hedj/radio/README.md

radio
=====

A minimal software-defined radio, based on the GreenArrays GA144A12 microprocessor.
Provision is made for connection to a Raspberry Pi B+ and shields. The GA144 analog
i/o pins are brought out to pin-headers to allow for different choices of RF frontends.
