hedj/radio/hardware/radio.kicad_pcb

## KiCad design hardware/radio.kicad_pcb (2015-06-11)

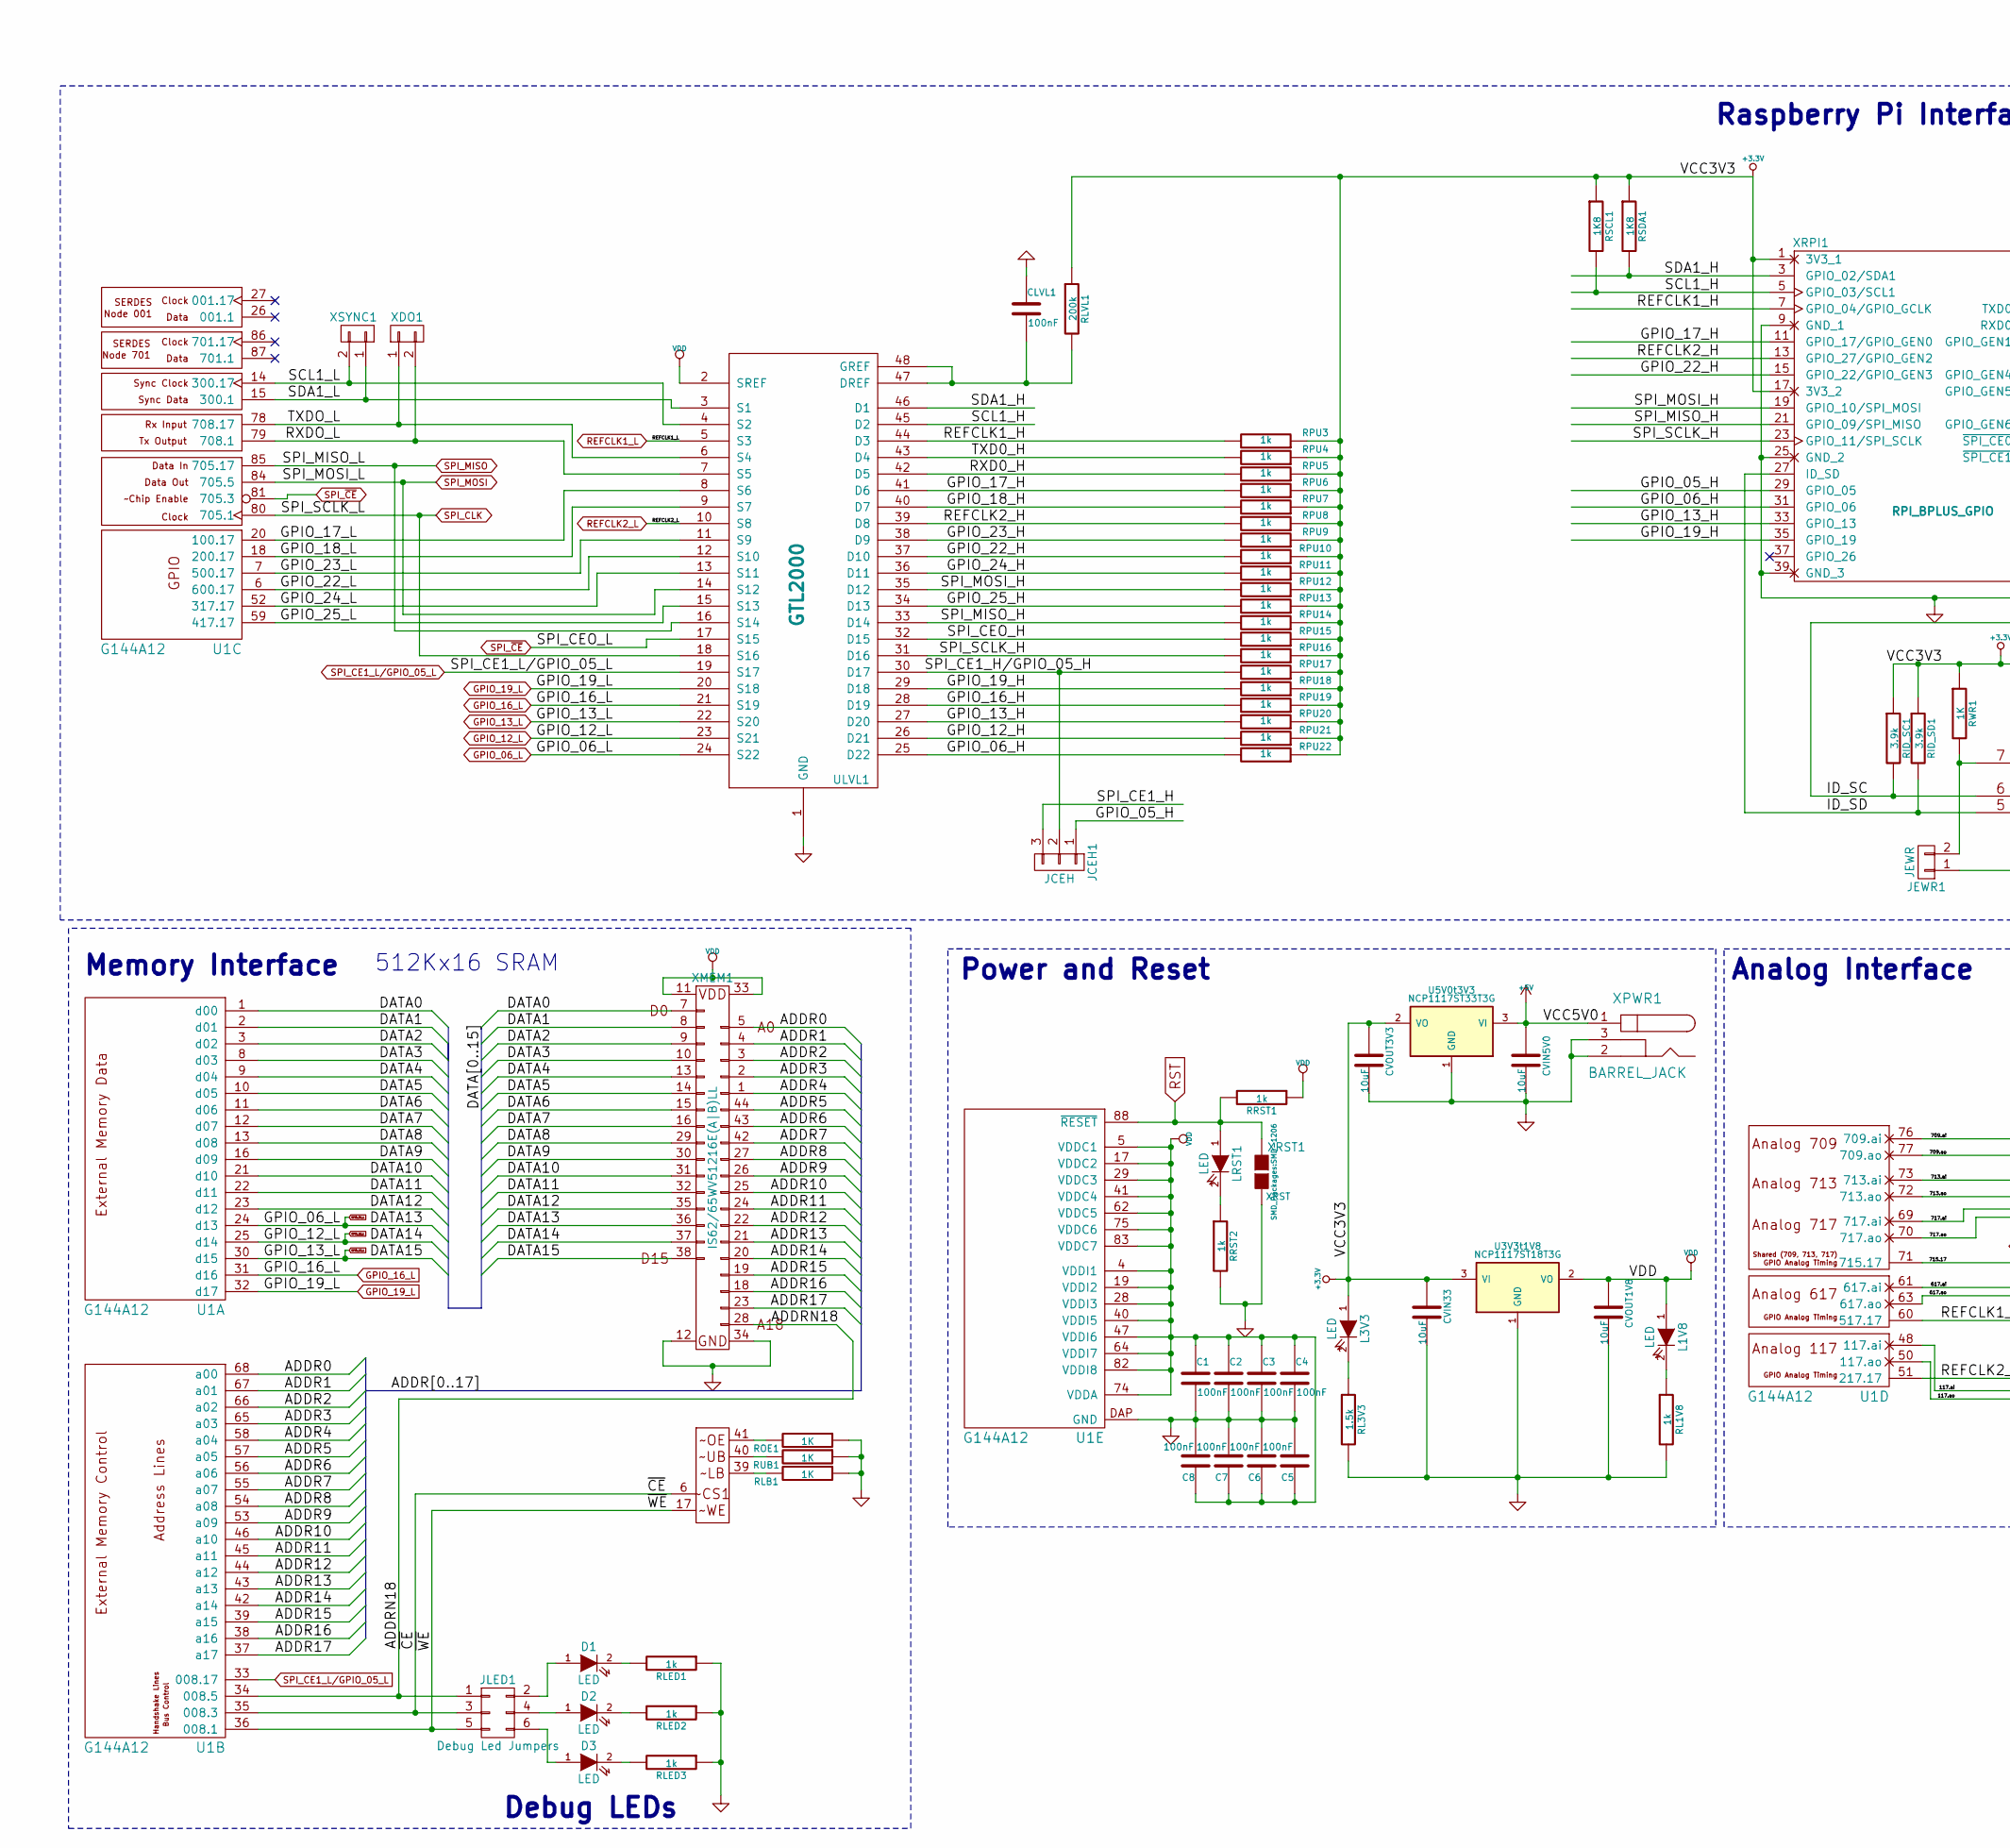
[picture p1: schematic radio.sch, part in row 1, column 1]

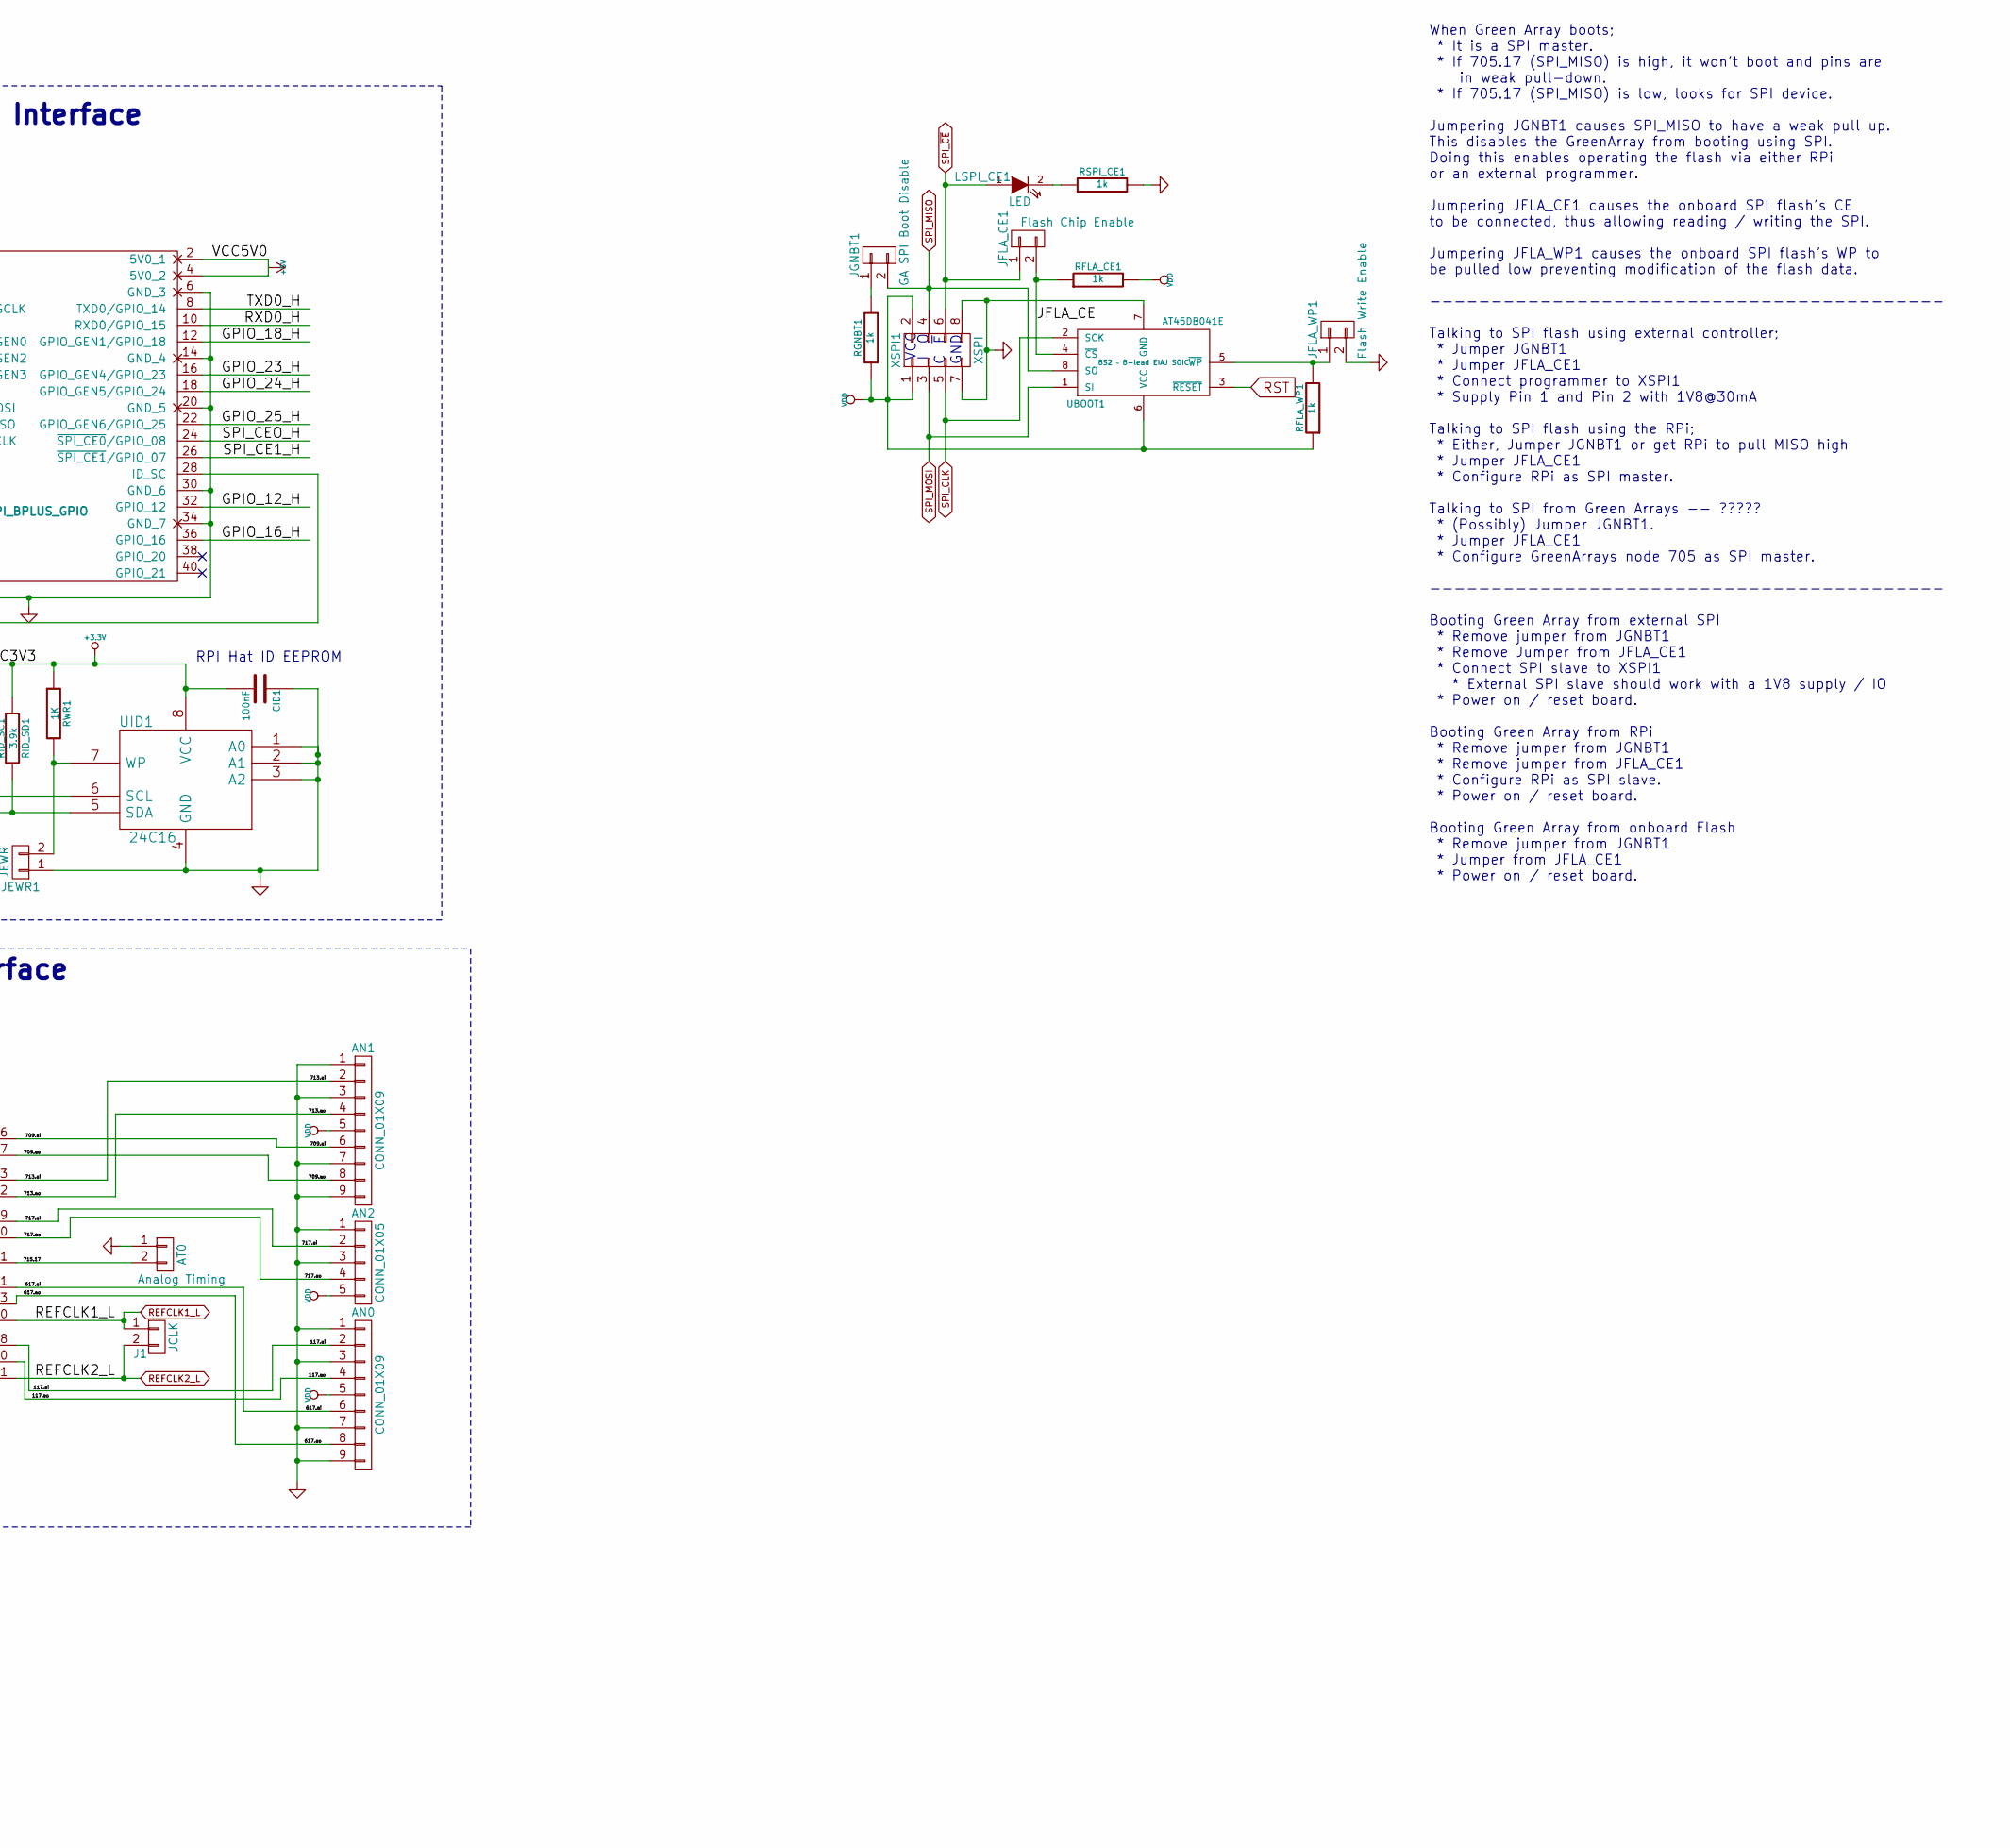
[picture p2: schematic radio.sch, part in row 1, column 2]

Parts:
AN0, AN1: CONN_01X09; Pin_Header_Straight_1x09
AN2: CONN_01X05; Pin_Header_Straight_1x05
AT0: Analog Timing; Pin_Header_Straight_1x02
C1, C2, C3, C4, C5, C6, C7, C8: 100nF; SMD-0603
CID1: 100nF; SMD-0603
CLVL1: 100nF; SMD-0603
CVIN5V0, CVIN33: 10uF; SMD-0805
CVOUT1V8, CVOUT3V3: 10uF; SMD-0805
D1, D2, D3: LED; LED-0805
J1: JCLK; Pin_Header_Straight_1x02
JCEH1: JCEH; Pin_Header_Straight_1x03
JEWR1: JEWR; Pin_Header_Straight_1x02
JFLA_CE1: Flash Chip Enable; Pin_Header_Straight_1x02
JFLA_WP1: Flash Write Enable; Pin_Header_Straight_1x02
JGNBT1: GA SPI Boot Disable; Pin_Header_Straight_1x02
JLED1: Debug Led Jumpers; Pin_Header_Straight_2x03
L1V8, L3V3: LED; LED-0805
LRST1: LED; LED-0805
LSPI_CE1: LED; LED-0805
RFLA_CE1: 1k; R_0603
RFLA_WP1: 1k; R_0603
RGNBT1: 1k; R_0603
RID_SC1: 3.9k; R_0603
RID_SD1: 3.9k; R_0603
RL1V8: 1k; R_0603
RL3V3: 1.5k; R_0603
RLB1: 1K; R_0603
RLED1, RLED2, RLED3: 1k; R_0603
RLVL1: 200k; R_0603
ROE1: 1K; R_0603
RPU3, RPU4, RPU5, RPU6, RPU7, RPU8, RPU9, RPU10, RPU11, RPU12, RPU13, RPU14, RPU15, RPU16, RPU17, RPU18, RPU19, RPU20, RPU21, RPU22: 1k; R_0603
RRST1, RRST2: 1k; R_0603
RSCL1: 1K8; R_0603
RSDA1: 1K8; R_0603
RSPI_CE1: 1k; R_0603
RUB1: 1K; R_0603
RWR1: 1K; R_0603
U1: G144A12; qfn88
U3V3t1V8: NCP1117ST18T3G; SOT-223
U5V0t3V3: NCP1117ST33T3G; SOT-223
UBOOT1: AT45DB041E; SOIC-8-N
UID1: 24C16; SOIC-8-N
ULVL1: GTL2000; TSSOP-48
XDO1: Pin_Header_Straight_1x02
XMEM1: IS62/65WV51216E(A|B)LL; TSSOPII-44_0.8mmPitch
XPWR1: BARREL_JACK
XRPI1: RPI_BPLUS_GPIO; PIN_20X2
XRST1: XRST; SMD-1206
XSPI1: XSPI; Pin_Header_Straight_2x04
XSYNC1: Pin_Header_Straight_1x02

Connections:
+3.3V: CID1.2, CVIN33.1, CVOUT3V3.1, L3V3.1 (A), RID_SC1.1, RID_SD1.1, RLVL1.1, RPU3.1, RPU4.1, RPU5.1, RPU6.1, RPU7.1, RPU8.1, RPU9.1, RPU10.1, RPU11.1, RPU12.1, RPU13.1, RPU14.1, RPU15.1, RPU16.1, RPU17.1, RPU18.1, RPU19.1, RPU20.1, RPU21.1, RPU22.1, RSCL1.1, RSDA1.1, RWR1.1, U3V3t1V8.3 (VI), U5V0t3V3.2 (VO), U5V0t3V3.4, UID1.8 (VCC), XRPI1.1 (3V3_1), XRPI1.17 (3V3_2)
+5V: CVIN5V0.1, U5V0t3V3.3 (VI), XPWR1.1, XRPI1.2 (5V0_1), XRPI1.4 (5V0_2)
/117.ai: AN0.2, U1.48 (117.ai)
/117.ao: AN0.4, U1.50 (117.ao)
/617.ai: AN0.6, U1.61 (617.ai)
/617.ao: AN0.8, U1.63 (617.ao)
/709.ai: AN1.6, U1.76 (709.ai)
/709.ao: AN1.8, U1.77 (709.ao)
/713.ai: AN1.2, U1.73 (713.ai)
/713.ao: AN1.4, U1.72 (713.ao)
/715.17: AT0.2, U1.71 (715.17)
/717.ai: AN2.2, U1.69 (717.ai)
/717.ao: AN2.4, U1.70 (717.ao)
/ADDR0: U1.68 (a00), XMEM1.5
/ADDR1: U1.67 (a01), XMEM1.4
/ADDR2: U1.66 (a02), XMEM1.3
/ADDR3: U1.65 (a03), XMEM1.2
/ADDR4: U1.58 (a04), XMEM1.1
/ADDR5: U1.57 (a05), XMEM1.44
/ADDR6: U1.56 (a06), XMEM1.43
/ADDR7: U1.55 (a07), XMEM1.42
/ADDR8: U1.54 (a08), XMEM1.27
/ADDR9: U1.53 (a09), XMEM1.26
/ADDR10: U1.46 (a10), XMEM1.25
/ADDR11: U1.45 (a11), XMEM1.24
/ADDR12: U1.44 (a12), XMEM1.22
/ADDR13: U1.43 (a13), XMEM1.21
/ADDR14: U1.42 (a14), XMEM1.20
/ADDR15: U1.39 (a15), XMEM1.19
/ADDR16: U1.38 (a16), XMEM1.18
/ADDR17: U1.37 (a17), XMEM1.23
/ADDRN18: JLED1.1, U1.34 (008.5), XMEM1.28
/DATA0: U1.1 (d00), XMEM1.7
/DATA1: U1.2 (d01), XMEM1.8
/DATA2: U1.3 (d02), XMEM1.9
/DATA3: U1.8 (d03), XMEM1.10
/DATA4: U1.9 (d04), XMEM1.13
/DATA5: U1.10 (d05), XMEM1.14
/DATA6: U1.11 (d06), XMEM1.15
/DATA7: U1.12 (d07), XMEM1.16
/DATA8: U1.13 (d08), XMEM1.29
/DATA9: U1.16 (d09), XMEM1.30
/DATA10: U1.21 (d10), XMEM1.31
/DATA11: U1.22 (d11), XMEM1.32
/DATA12: U1.23 (d12), XMEM1.35
/GPIO_05_H: JCEH1.1, XRPI1.29 (GPIO_05)
/GPIO_06_H: RPU22.2, ULVL1.25 (D22), XRPI1.31 (GPIO_06)
/GPIO_12_H: RPU21.2, ULVL1.26 (D21), XRPI1.32 (GPIO_12)
/GPIO_13_H: RPU20.2, ULVL1.27 (D20), XRPI1.33 (GPIO_13)
/GPIO_16_H: RPU19.2, ULVL1.28 (D19), XRPI1.36 (GPIO_16)
/GPIO_17_H: RPU6.2, ULVL1.41 (D6), XRPI1.11 (GPIO_17/GPIO_GEN0)
/GPIO_17_L: U1.20 (100.17), ULVL1.8 (S6)
/GPIO_18_H: RPU7.2, ULVL1.40 (D7), XRPI1.12 (GPIO_GEN1/GPIO_18)
/GPIO_18_L: U1.18 (200.17), ULVL1.9 (S7)
/GPIO_19_H: RPU18.2, ULVL1.29 (D18), XRPI1.35 (GPIO_19)
/GPIO_22_H: RPU10.2, ULVL1.37 (D10), XRPI1.15 (GPIO_22/GPIO_GEN3)
/GPIO_22_L: U1.6 (600.17), ULVL1.12 (S10)
/GPIO_23_H: RPU9.2, ULVL1.38 (D9), XRPI1.16 (GPIO_GEN4/GPIO_23)
/GPIO_23_L: U1.7 (500.17), ULVL1.11 (S9)
/GPIO_24_H: RPU11.2, ULVL1.36 (D11), XRPI1.18 (GPIO_GEN5/GPIO_24)
/GPIO_24_L: U1.52 (317.17), ULVL1.13 (S11)
/GPIO_25_H: RPU13.2, ULVL1.34 (D13), XRPI1.22 (GPIO_GEN6/GPIO_25)
/GPIO_25_L: U1.59 (417.17), ULVL1.15 (S13)
/ID_SC: RID_SC1.2, UID1.6 (SCL), XRPI1.28 (ID_SC)
/ID_SD: RID_SD1.2, UID1.5 (SDA), XRPI1.27 (ID_SD)
/JFLA_CE: JFLA_CE1.2, RFLA_CE1.1, UBOOT1.4 (~CS)
/REFCLK1_H: RPU3.2, ULVL1.44 (D3), XRPI1.7 (GPIO_04/GPIO_GCLK)
/REFCLK2_H: RPU8.2, ULVL1.39 (D8), XRPI1.13 (GPIO_27/GPIO_GEN2)
/RXD0_H: RPU5.2, ULVL1.42 (D5), XRPI1.10 (RXD0/GPIO_15)
/RXDO_L: U1.79 (708.1), ULVL1.7 (S5), XDO1.2
/SCL1_H: RSCL1.2, ULVL1.45 (D2), XRPI1.5 (GPIO_03/SCL1)
/SCL1_L: U1.14 (300.17), ULVL1.4 (S2), XSYNC1.2
/SDA1_H: RSDA1.2, ULVL1.46 (D1), XRPI1.3 (GPIO_02/SDA1)
/SDA1_L: U1.15 (300.1), ULVL1.3 (S1), XSYNC1.1
/SPI_CE1_H: JCEH1.3, XRPI1.26 (~SPI_CE1~/GPIO_07)
/SPI_CE1_H/GPIO_05_H: JCEH1.2, RPU17.2, ULVL1.30 (D17)
/SPI_CEO_H: RPU15.2, ULVL1.32 (D15), XRPI1.24 (~SPI_CE0~/GPIO_08)
/SPI_MISO_H: RPU14.2, ULVL1.33 (D14), XRPI1.21 (GPIO_09/SPI_MISO)
/SPI_MOSI_H: RPU12.2, ULVL1.35 (D12), XRPI1.19 (GPIO_10/SPI_MOSI)
/SPI_SCLK_H: RPU16.2, ULVL1.31 (D16), XRPI1.23 (GPIO_11/SPI_SCLK)
/TXD0_H: RPU4.2, ULVL1.43 (D4), XRPI1.8 (TXD0/GPIO_14)
/TXDO_L: U1.78 (708.17), ULVL1.6 (S4), XDO1.1
/~CE: JLED1.3, U1.35 (008.3), XMEM1.6
/~WE: JLED1.5, U1.36 (008.1), XMEM1.17
GND: AN0.1, AN0.3, AN0.7, AN0.9, AN1.1, AN1.3, AN1.7, AN1.9, AN2.1, AN2.3, AT0.1, C1.2, C2.2, C3.2, C4.2, C5.2, C6.2, C7.2, C8.2, CID1.1, CLVL1.1, CVIN5V0.2, CVIN33.2, CVOUT1V8.2, CVOUT3V3.2, JEWR1.1, JFLA_WP1.2, RL1V8.2, RL3V3.2, RLB1.1, RLED1.1, RLED2.1, RLED3.1, ROE1.1, RRST2.2, RSPI_CE1.2, RUB1.1, U1.DAP (GND), U3V3t1V8.1 (GND), U5V0t3V3.1 (GND), UBOOT1.7 (GND), UID1.1 (A0), UID1.2 (A1), UID1.3 (A2), UID1.4 (GND), ULVL1.1 (GND), XMEM1.12, XMEM1.34, XPWR1.2, XPWR1.3, XRPI1.6 (GND_3), XRPI1.9 (GND_1), XRPI1.14 (GND_4), XRPI1.20 (GND_5), XRPI1.25 (GND_2), XRPI1.30 (GND_6), XRPI1.34 (GND_7), XRPI1.39 (GND_3), XRST1.2 (G2), XSPI1.7, XSPI1.8
GPIO_06_L: U1.24 (d13), ULVL1.24 (S22), XMEM1.36
GPIO_12_L: U1.25 (d14), ULVL1.23 (S21), XMEM1.37
GPIO_13_L: U1.30 (d15), ULVL1.22 (S20), XMEM1.38
GPIO_16_L: U1.31 (d16), ULVL1.21 (S19)
GPIO_19_L: U1.32 (d17), ULVL1.20 (S18)
unnamed: CLVL1.2, RLVL1.2, ULVL1.47 (DREF), ULVL1.48 (GREF)
unnamed: D1.1 (A), JLED1.2
unnamed: D1.2 (K), RLED1.2
unnamed: D2.1 (A), JLED1.4
unnamed: D2.2 (K), RLED2.2
unnamed: D3.1 (A), JLED1.6
unnamed: D3.2 (K), RLED3.2
unnamed: JEWR1.2, RWR1.2, UID1.7 (WP)
unnamed: JFLA_WP1.1, RFLA_WP1.2, UBOOT1.5 (~WP)
unnamed: JGNBT1.1, RGNBT1.2
unnamed: L1V8.2 (K), RL1V8.1
unnamed: L3V3.2 (K), RL3V3.1
unnamed: LRST1.2 (K), RRST2.1
unnamed: LSPI_CE1.2 (K), RSPI_CE1.1
unnamed: RLB1.2, XMEM1.39
unnamed: ROE1.2, XMEM1.41
unnamed: RUB1.2, XMEM1.40
REFCLK1_L: J1.1, U1.60 (517.17), ULVL1.5 (S3)
REFCLK2_L: J1.2, U1.51 (217.17), ULVL1.10 (S8)
RST: LRST1.1 (A), RRST1.2, U1.88 (~RESET), UBOOT1.3 (~RESET), XRST1.1 (G1)
SPI_CE1_L/GPIO_05_L: U1.33 (008.17), ULVL1.19 (S17)
SPI_CLK: U1.80 (705.1), UBOOT1.2 (SCK), ULVL1.18 (S16), XSPI1.5
SPI_MISO: JGNBT1.2, U1.85 (705.17), UBOOT1.8 (SO), ULVL1.16 (S14), XSPI1.4
SPI_MOSI: U1.84 (705.5), UBOOT1.1 (SI), ULVL1.14 (S12), XSPI1.3
SPI_~CE: JFLA_CE1.1, LSPI_CE1.1 (A), U1.81 (705.3), ULVL1.17 (S15), XSPI1.6
VDD: AN0.5, AN1.5, AN2.5, C1.1, C2.1, C3.1, C4.1, C5.1, C6.1, C7.1, C8.1, CVOUT1V8.1, L1V8.1 (A), RFLA_CE1.2, RFLA_WP1.1, RGNBT1.1, RRST1.1, U1.4 (VDDI1), U1.5 (VDDC1), U1.17 (VDDC2), U1.19 (VDDI2), U1.28 (VDDI3), U1.29 (VDDC3), U1.40 (VDDI5), U1.41 (VDDC4), U1.47 (VDDI6), U1.62 (VDDC5), U1.64 (VDDI7), U1.74 (VDDA), U1.75 (VDDC6), U1.82 (VDDI8), U1.83 (VDDC7), U3V3t1V8.2 (VO), U3V3t1V8.4, UBOOT1.6 (VCC), ULVL1.2 (SREF), XMEM1.11, XMEM1.33, XSPI1.1, XSPI1.2

Notes on the sheet:
Analog Interface
Power and Reset
Raspberry Pi Interface
Memory Interface
Debug LEDs
RPI Hat ID EEPROM
GND
VCC
512Kx16 SRAM
When Green Array boots; * It is a SPI master. * If 705.17 (SPI_MISO) is high, it won't boot and pins are in weak pull-down. * If 705.17 (SPI_MISO) is low, looks for SPI device. Jumpering JGNBT1 causes SPI_MISO to have a weak pull up. This disables the GreenArray from booting using SPI. Doing this e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

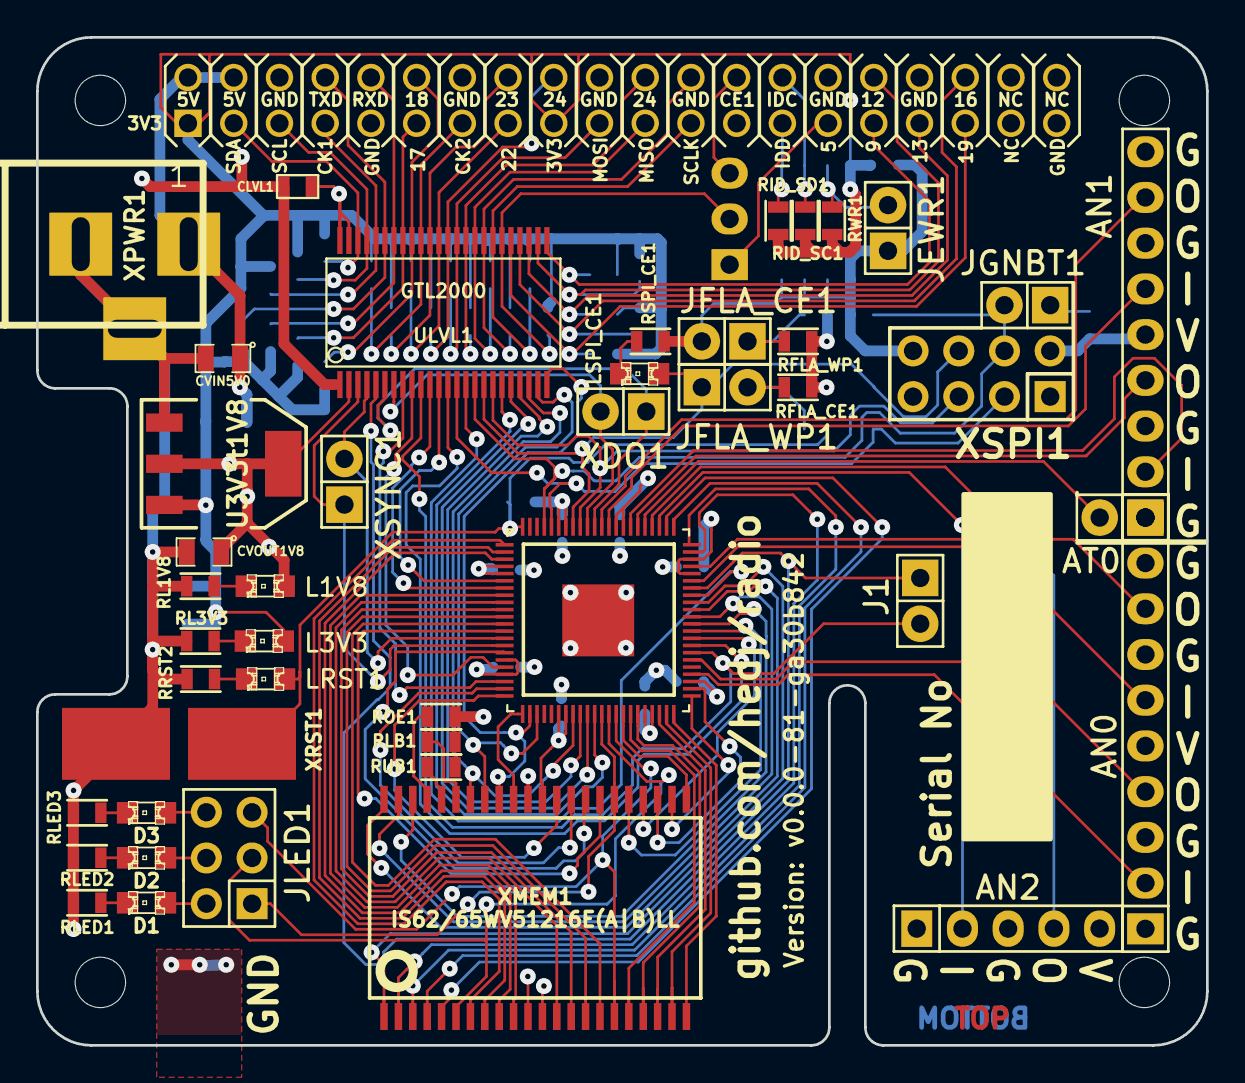
[picture p3: board radio.kicad_pcb from above]

Board: 4 copper layers, 65.0 x 56.0 mm, 89 parts (0 on the bottom side), 116 nets.

Other parts of the board:
@HOLE0, @HOLE1, @HOLE2, @HOLE3: (no value)
