hedj/radio/hardware/antenna.kicad_pcb

## KiCad design hardware/antenna.kicad_pcb (2015-06-06)

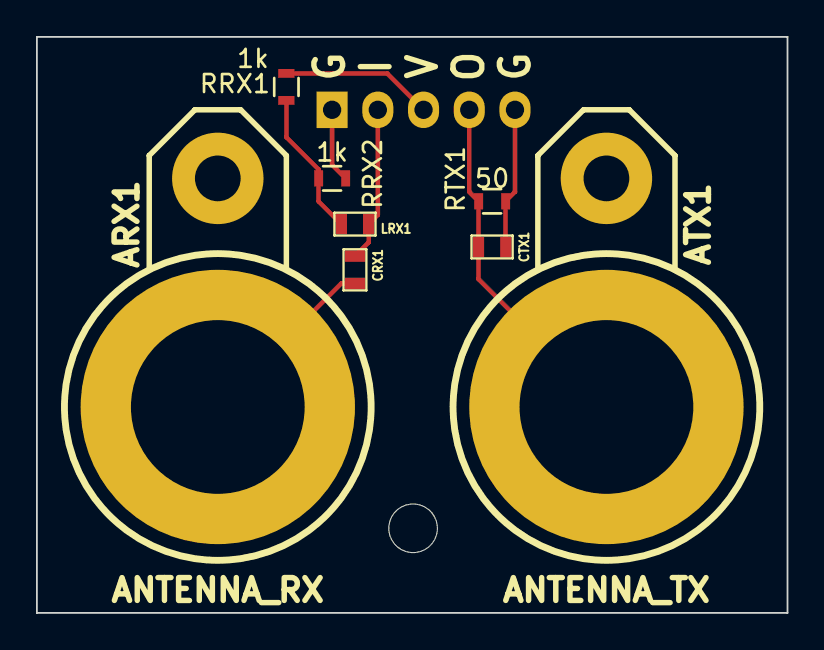
[picture p4: board antenna.kicad_pcb from above]

Board: 2 copper layers, 41.7 x 32.0 mm, 10 parts (1 on the bottom side), 6 nets.

Parts:
ARX1: ANTENNA_RX; bnc
ATX1: ANTENNA_TX; bnc
CRX1: 0.1uF; SMD-0603
CTX1: 320pF; SMD-0603
LRX1: 160nH; SMD-0603
MountingHole_2-7mm: VAL**; MountingHole_2-7mm
P1: CONN_01X05; Pin_Header_Straight_1x05
RRX1, RRX2: 1k; R_0603
RTX1: 50; R_0603

Connections:
AGND: ARX1.1, ATX1.1, CTX1.2, P1.1, P1.5, RRX2.2, RTX1.2
unnamed: ARX1.2, CRX1.1
unnamed: ATX1.2, CTX1.1, P1.4, RTX1.1
unnamed: CRX1.2, LRX1.2, P1.2
unnamed: LRX1.1, RRX1.2, RRX2.1
VDD: P1.3, RRX1.1
