hedj/radio/(threads)

Thread 3 (2015-04-14):

Extend solder pads for RAM chip

mithro, 2015-04-14:
The solder pads are too short for hand soldering. They need to be extended abit.

Closed 2015-06-03.

Thread 4 (2015-04-14):

Redo the power connector

mithro, 2015-04-14:

mithro, 2015-04-14:
The currently purchased version doesn't match the footprint.

mithro, 2015-06-03:
Purchase 5 of http://www.digikey.com/scripts/DkSearch/dksus.dll?Detail&itemSeq=173436971&uq=635689110560850630

Closed 2015-06-03.

Thread 5 (2015-04-14):

Extend the Green Array solder pads

mithro, 2015-04-14:
The Green Array pads are too short to be hand solderable.

Closed 2015-06-03.

Thread 6 (2015-04-14):

Get a new reset switch

mithro, 2015-04-14:
The current one purchased doesn't match the footprint.

mithro, 2015-06-05:
I just went with a large pad which will support multiple different types of switches.

Closed 2015-06-05.

Thread 13 (2015-06-27):

JFLA_CE1 and JFLA_WP1 silk screen labels should be swapped

mithro, 2015-06-27:
They are on the wrong side of the connectors which makes it confusing.

Thread 14 (2015-06-27):

Replace pull up resistors with resistor arrays.

mithro, 2015-06-27:
This would reduce the amount of soldering needed.

Thread 15 (2015-06-27):

Raspberry PI has no way of doing a hard reset of the GreenArrays chip.

mithro, 2015-06-27:
The RESET net is not connected to the Raspberry Pi and it has no control over the 3.3V supply to the board either. This means if the GreenArrays locks up in any way, you must press the reset button to reset the system.

Thread 17 (2015-06-27):

There isn't enough clearance between standoffs and the analog board connectors

mithro, 2015-06-27:
You can't really put any nuts on the standoffs or anything.

Thread 18 (2015-06-27):

Figure out why when board initially powers on it pulls 90mA, but after reset it goes to 10mA

mithro, 2015-06-27:
When power is initially connected to VCC3V3 the board starts drawing 90mA, but after asserting the reset line the board goes to only drawing 10mA.

mithro, 2015-06-29:
@hedj - Any idea what might be going on here?

Thread 19 (2015-06-27):

Need program for SPI flash which flashes the LEDs in a nice pattern.

mithro, 2015-06-27:
The LEDs are connected to;
 * D1 -> 008.5 (pin 34)
 * D2 -> 008.3 (pin 35)
 * D3 -> 008.1 (pin 36)

mithro, 2015-06-27:
@hedj - This task is for you :)

Thread 23 (2016-08-03):

Accidently deleted antenna board?

mithro, 2016-08-03:
It looks like you have accidently deleted the schematic in https://github.com/hedj/radio/commit/c5952ea59f1b8f2a943819fa592a28a82442f86b

Probably want to keep it?
