hedj/radio/(commit log)

2014-09-09 Cleanup redundant and obsolete files
    [footprint.sch]
2014-09-09 Add garfc, remove redundant files.
    [radio-4.sch]
2014-09-09 Add PDFs of schematics
2014-09-13 Fully created schematic and footprint associations.
    [radio.kicad_pcb, radio.sch]
2014-09-13 Partially routed schematic.
    [radio.kicad_pcb, radio.sch]
2014-09-13 Totally rework how the pull up resistors work.
    [radio.kicad_pcb, radio.sch]
2014-09-13 More routing of stuff.
    [radio.kicad_pcb]
2014-09-13 Minor fixes.
    [radio.kicad_pcb, radio.sch]
2014-09-14 Swapping SDA and SCLK to make routing easier.
    [radio.kicad_pcb]
2014-09-15 Adding SPI flash and changing the SPI setup.
    [radio.kicad_pcb, radio.sch]
2014-10-18 Adding mini-PCI Express expansion board as dependency.
2014-11-01 Adding the SATA connector library.
2014-11-01 Temporary commit with latest updated.
    [radio.kicad_pcb, radio.sch]
2014-11-01 Moving the antenna onto its own board.
    [antenna.sch]
2014-11-01 Removing the antenna from the radio schematic.
    [radio.sch]
2014-11-01 Preparing to hook up mPCIe connector and adding documentation.
    [radio.sch]
2014-11-01 Lots of different fixes.
    * Removing mpcie and replacing with onboard memory (freeing up some pins).
    * Changing the SPI configuration (don't actually need the fancy 3 way header).
    Added lots of documentation how to work with SPI flash for booting,
    programming, etc.
    * Fixed all the electrical DRC errors.
    [radio.sch]
2014-11-01 Adding a LED onto the SPI CE to make debugging easier.
    [radio.sch]
2014-11-01 Removing mpcie from PCB library.
2014-11-01 Temporary commit.
    [radio.sch]
2014-11-01 Use custom SATA connector for design-rule compatibility
    [antenna.sch]
2014-11-01 Adding SATA PCB module.
    [radio.sch]
2014-11-01 Back to pin headers rather than SATA connectors.
    [radio.sch]
2014-11-01 Bit of a cleanup, temporary commit.
    [radio.kicad_pcb]
2014-11-01 Fixing XSPI connector.
    [radio.sch]
2014-11-01 Temporary commit for netlist import.
    [radio.kicad_pcb, radio.sch]
2014-11-01 Imported new netlist and lined up analog headers.
    [radio.kicad_pcb]
2014-11-01 Starting initial layout of parts.
    [radio.kicad_pcb]
2014-11-02 Initial PCB layout for antenna
    [antenna.kicad_pcb, antenna.sch]
2014-11-15 Fixing the ground plane fill.
    [antenna.kicad_pcb]
2014-11-15 Adding dimensions of the antenna board.
    [antenna.kicad_pcb]
2014-11-15 Adding dimensions to radio board.
    [radio.kicad_pcb]
2014-11-15 Placing the barrel jack and power supply.
    [radio.kicad_pcb]
2014-11-15 Temp commit.
    [radio.kicad_pcb]
2014-11-15 Using older 603 footprint.
    [radio.kicad_pcb]
2014-11-15 Getting LEDs and reset points right.
    [radio.kicad_pcb]
2014-11-15 More work.
    [radio.sch]
2014-11-15 Slowly getting there....
    [radio.kicad_pcb]
2014-11-15 Reorganising the Analog header for easier routing.
    [radio.kicad_pcb, radio.sch]
2014-11-15 Analog bits connected now.
    [radio.kicad_pcb]
2014-11-15 Removing the XSERDES1 header.
    [radio.sch]
2014-11-15 KiCad crashed :(
    [radio.kicad_pcb]
2014-11-15 Finished most of the SPI stuff.
    [radio.kicad_pcb]
2014-11-15 Adding decoupling capacitors.
    [radio.kicad_pcb]
2014-11-15 Decoupling capacitors connected up.
    [radio.kicad_pcb]
2014-11-16 Adding the UART header.
    [radio.kicad_pcb]
2014-11-16 All traces routed I think.
    [radio.kicad_pcb]
2014-11-16 Lots of small fixes.
    [radio.kicad_pcb]
2014-11-30 Making clearance 0.15**24** and trace width 0.15**24**.
    [radio.kicad_pcb]
2014-11-30 4 layer design.
    [radio.kicad_pcb]
2014-11-30 More 4 layer work.
    [radio.kicad_pcb]
2014-11-30 More optimisation.
    [radio.kicad_pcb]
2015-03-07 Getting close to first production run.
    [radio.kicad_pcb, radio.sch]
2015-03-07 Fixing up the antenna board.
    [antenna.kicad_pcb, antenna.sch]
2015-03-11 Small fixes.
    [radio.kicad_pcb]
2015-03-21 Small adjustments from doing paper fit.
    [antenna.kicad_pcb, radio.kicad_pcb]
2015-06-03 Extending the solder pads for the RAM chip.
    Fixes #3.
    [radio.kicad_pcb]
2015-06-03 Fixing some vias.
    [radio.kicad_pcb]
2015-06-03 Updating schematic and adding link to connector.
    [radio.sch]
2015-06-03 Making the qfn88 pads hand solderable.
    Fixes #5.
2015-06-03 Routing update.
    Also makes a huge pad for adding reset switches onto.
    Fixes #5 and #6.
    [radio.kicad_pcb]
2015-06-03 Small silkscreen updates.
    [radio.kicad_pcb]
2015-06-05 Fixing short on level shifter in top right hand corner.
    [radio.kicad_pcb]
2015-06-05 Adding raspberry pi labeling.
    Fixes #8.
    [radio.kicad_pcb]
2015-06-05 Fixing silkscreen issues.
    [radio.kicad_pcb]
2015-06-05 Adding more stuff to silk screen.
    [radio.kicad_pcb]
2015-06-05 Adding GND connection point for testing.
    [radio.kicad_pcb]
2015-06-05 More silkscreen updates.
    [radio.kicad_pcb]
2015-06-05 Adding openhardware logo.
    [radio.kicad_pcb]
2015-06-05 Fixing ground pad.
    [radio.kicad_pcb]
2015-06-05 Fix drill size for vias.
    [radio.kicad_pcb]
2015-06-05 Don't use extended gerbers
    [radio.kicad_pcb]
2015-06-05 First run gerbers.
    [radio-B_Cu.gbl, radio-B_Mask.gbs, radio-Edge_Cuts.gbr, radio-F_Cu.gtl, radio-F_Mask.gts, radio-F_SilkS.gto, radio-In1_Cu.gbr, radio-In2_Cu.gbr]
2015-06-06 Small fixes from Mitch (@hackvana).
    [radio.kicad_pcb]
2015-06-06 Version bump.
    [radio.kicad_pcb]
2015-06-06 Updating the gerbers.
    [radio-B_Cu.gbl, radio-B_Mask.gbs, radio-Edge_Cuts.gbr, radio-F_Cu.gtl, radio-F_Mask.gts, radio-F_SilkS.gto, radio-In1_Cu.gbr, radio-In2_Cu.gbr]
2015-06-19 Removing obsolete stuff.
    [radio-2.sch, radio-3.sch, radio.sch]
2015-06-19 Remove old library.
    [radio.sch]
2015-06-19 Fixing the values of the 1.8V connected LEDs.
    [radio.sch]
2015-07-12 Beginnings of an assembler.
